rlutz/voctoknopf/panel/CheatSheet.md

GCode cheat sheet
-----------------

Go to G54 zero:
```
G28.3 X0 Y0 Z0
```

Home:
```
G28.2 X0 Y0 Z0
```

Set G54 zero:
```
G10 L2 P1 X... Y... Z...
```

Absolute Zero Pre-Set (set current coordinates):
```
G92 X... Y... Z...
```
