rlutz/voctoknopf/panel/matrix3-preview.pdf

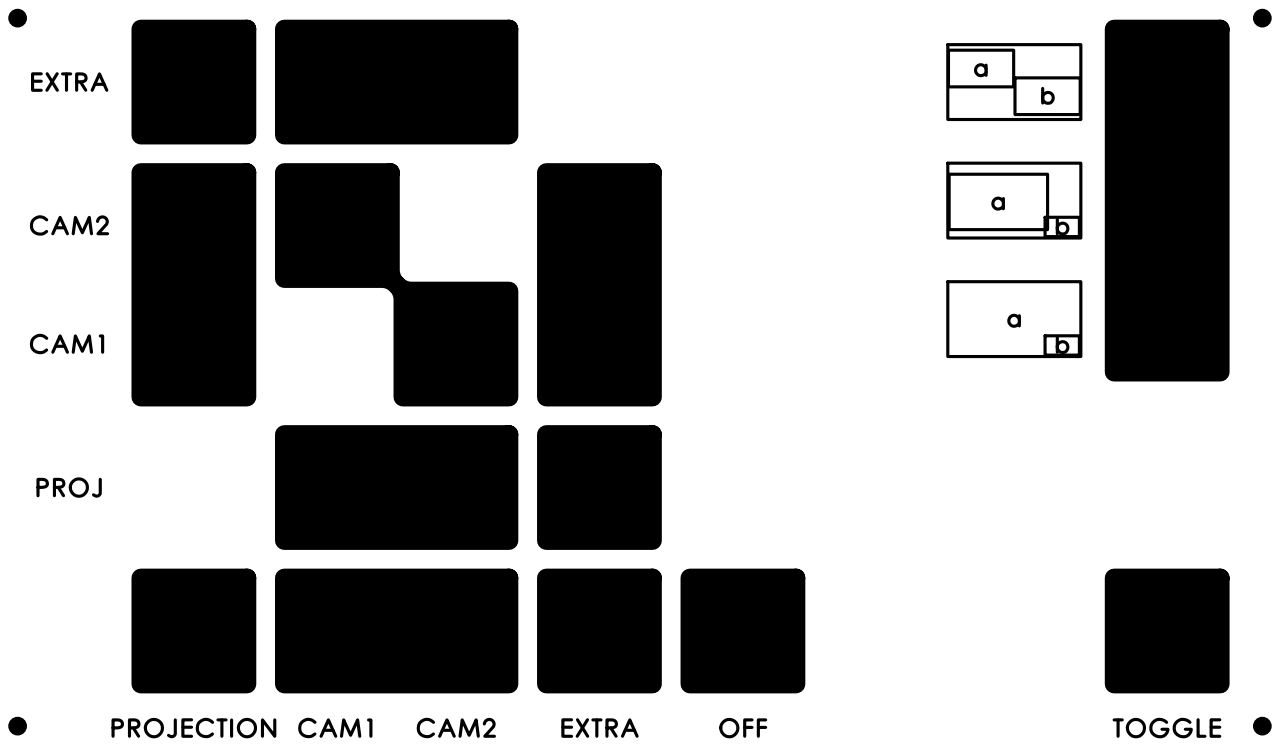
[picture p3: page 1]
