rlutz/voctoknopf/panel/p2-preview.png

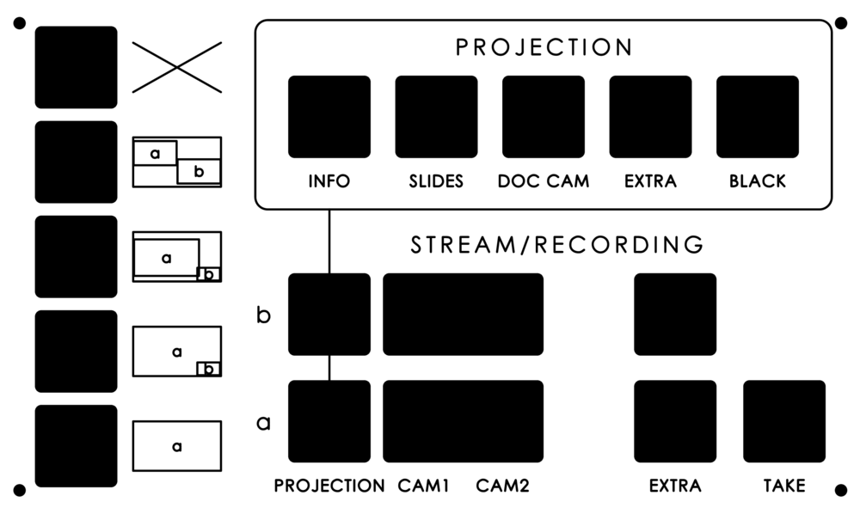
panel/p2-preview.png
