rlutz/voctoknopf/prototype-rear.jpg

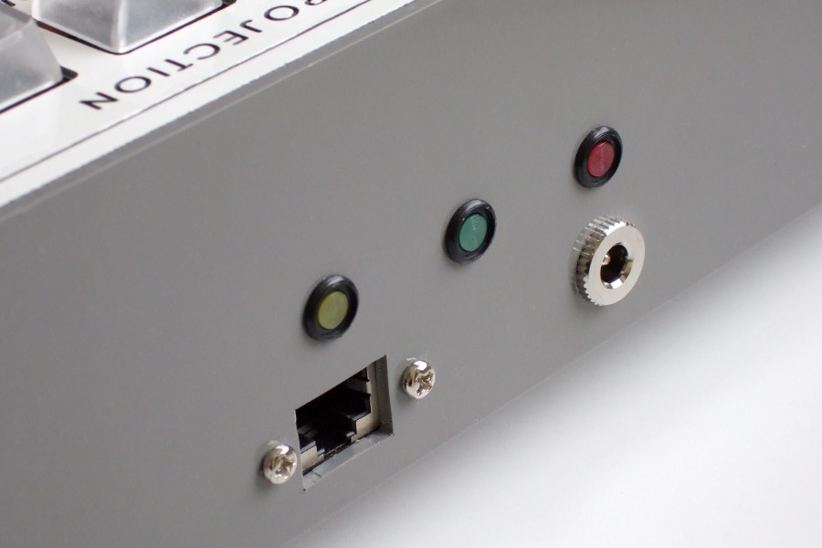
prototype-rear.jpg
