rlutz/voctoknopf/board/voctoknopf.pdf

## RT5350F-OLinuXino

# Power GND EXT1-2 GND EXT2-2

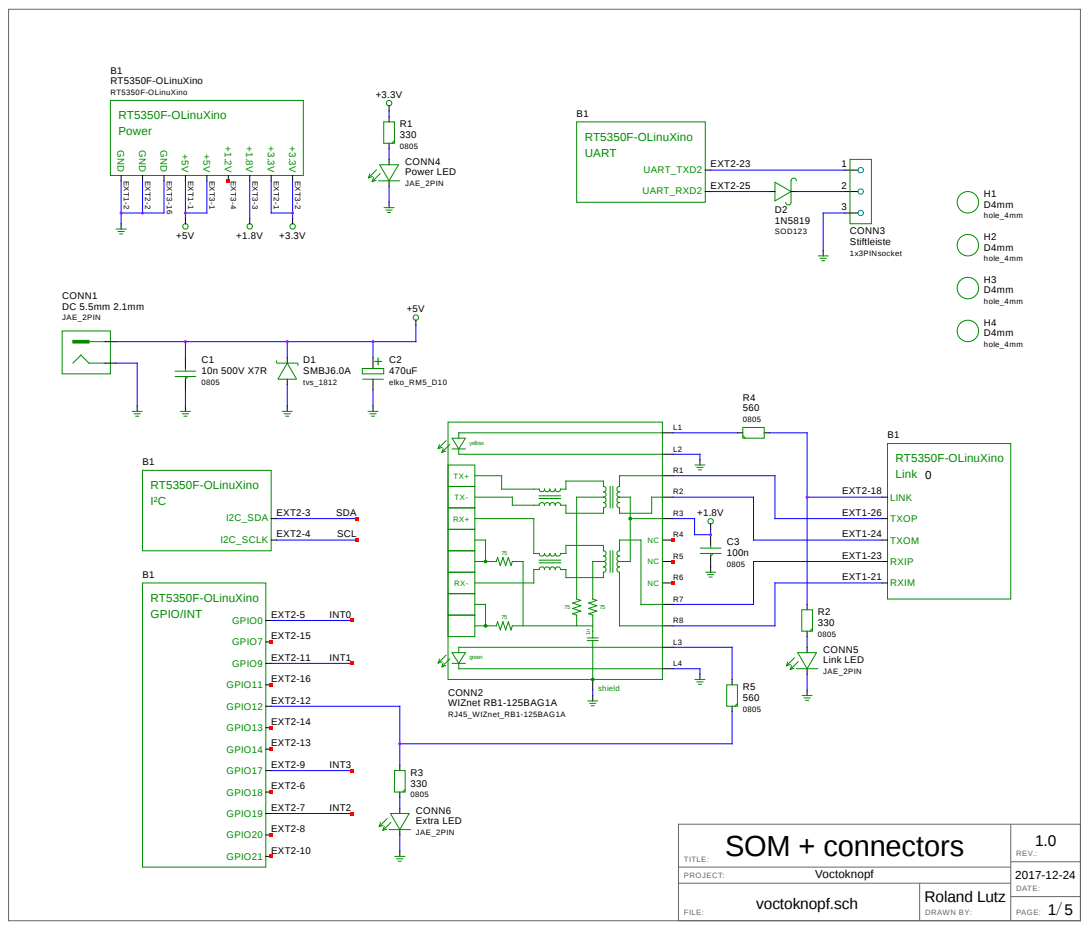
[picture p6: page 1]

## Red/green LED

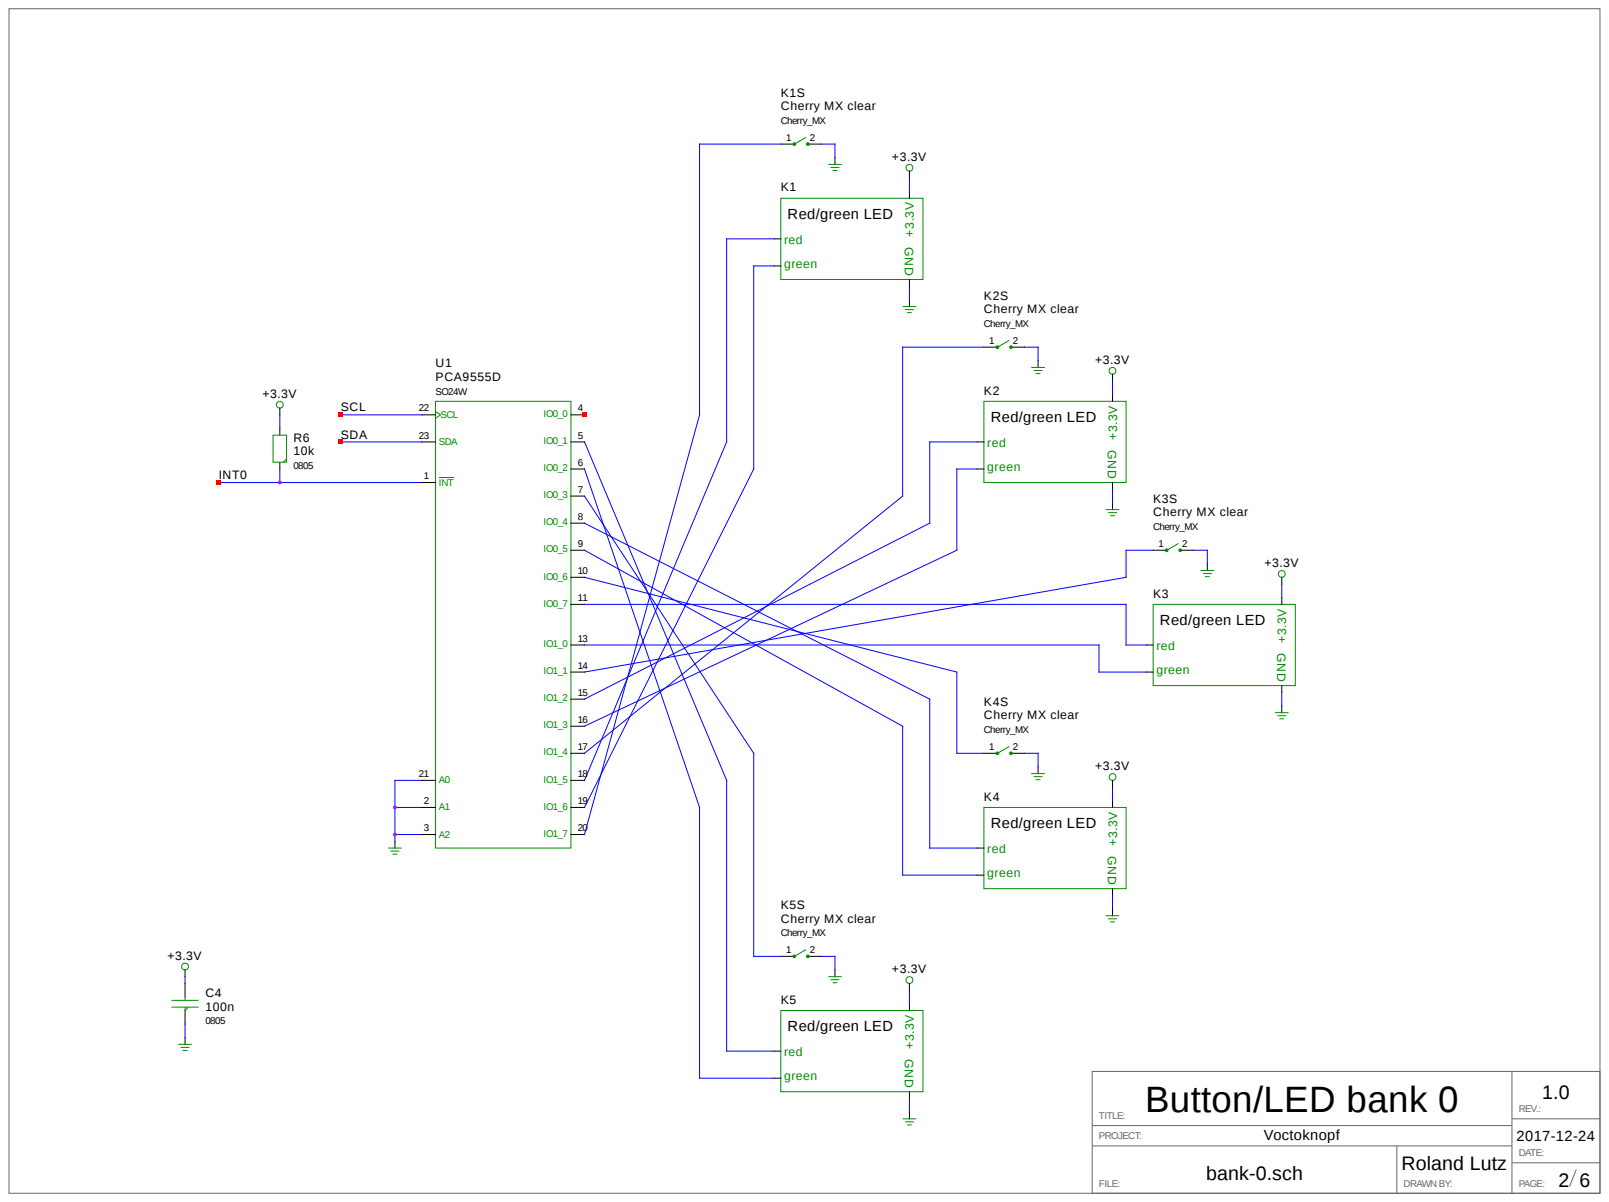
[picture p7: page 2]
TITLE:; REV.:; PROJECT:; bank-0.sch; Voctoknopf; SCL; SDA; INT0; K1S Cherry MX clear Cherry_MX; red; GND; green; 23 SDA; 22 SCL; 1 INT; U1 PCA9555D SO24W; K2S Cherry MX clear Cherry_MX; K3S Cherry MX clear Cherry_MX; K4S Cherry MX clear Cherry_MX; K5S Cherry MX clear Cherry_MX

Red/green LED

Button/LED bank 0

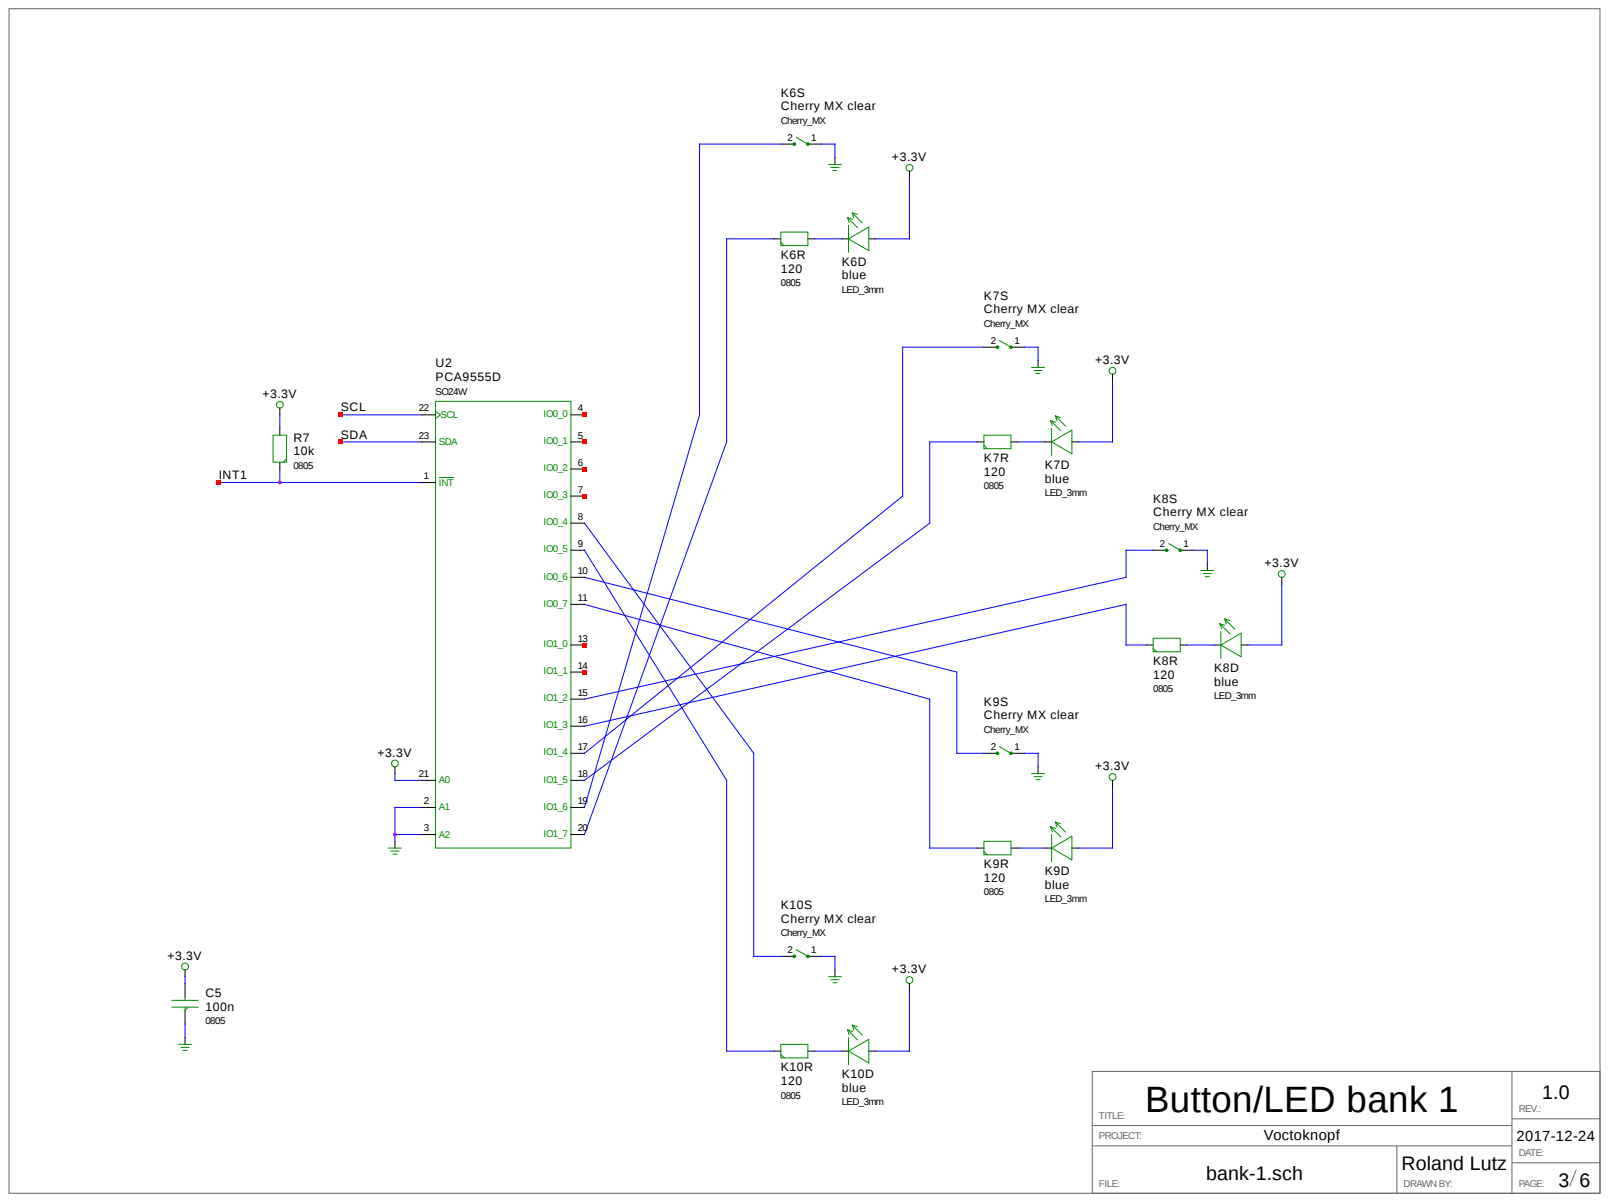
[picture p8: page 3]
TITLE:; REV.:; PROJECT:; bank-1.sch; Voctoknopf; SCL; SDA; INT1; K6S Cherry MX clear Cherry_MX; 23 SDA; 22 SCL; 1 INT; U2 PCA9555D SO24W; K7S Cherry MX clear Cherry_MX; K8S Cherry MX clear Cherry_MX; K9S Cherry MX clear Cherry_MX; K10S Cherry MX clear Cherry_MX; K6D blue LED_3mm; K7D blue LED_3mm; K8D blue LED_3mm; K9D blue LED_3mm; K10D blue LED_3mm

Button/LED bank 1

## Red/green LED

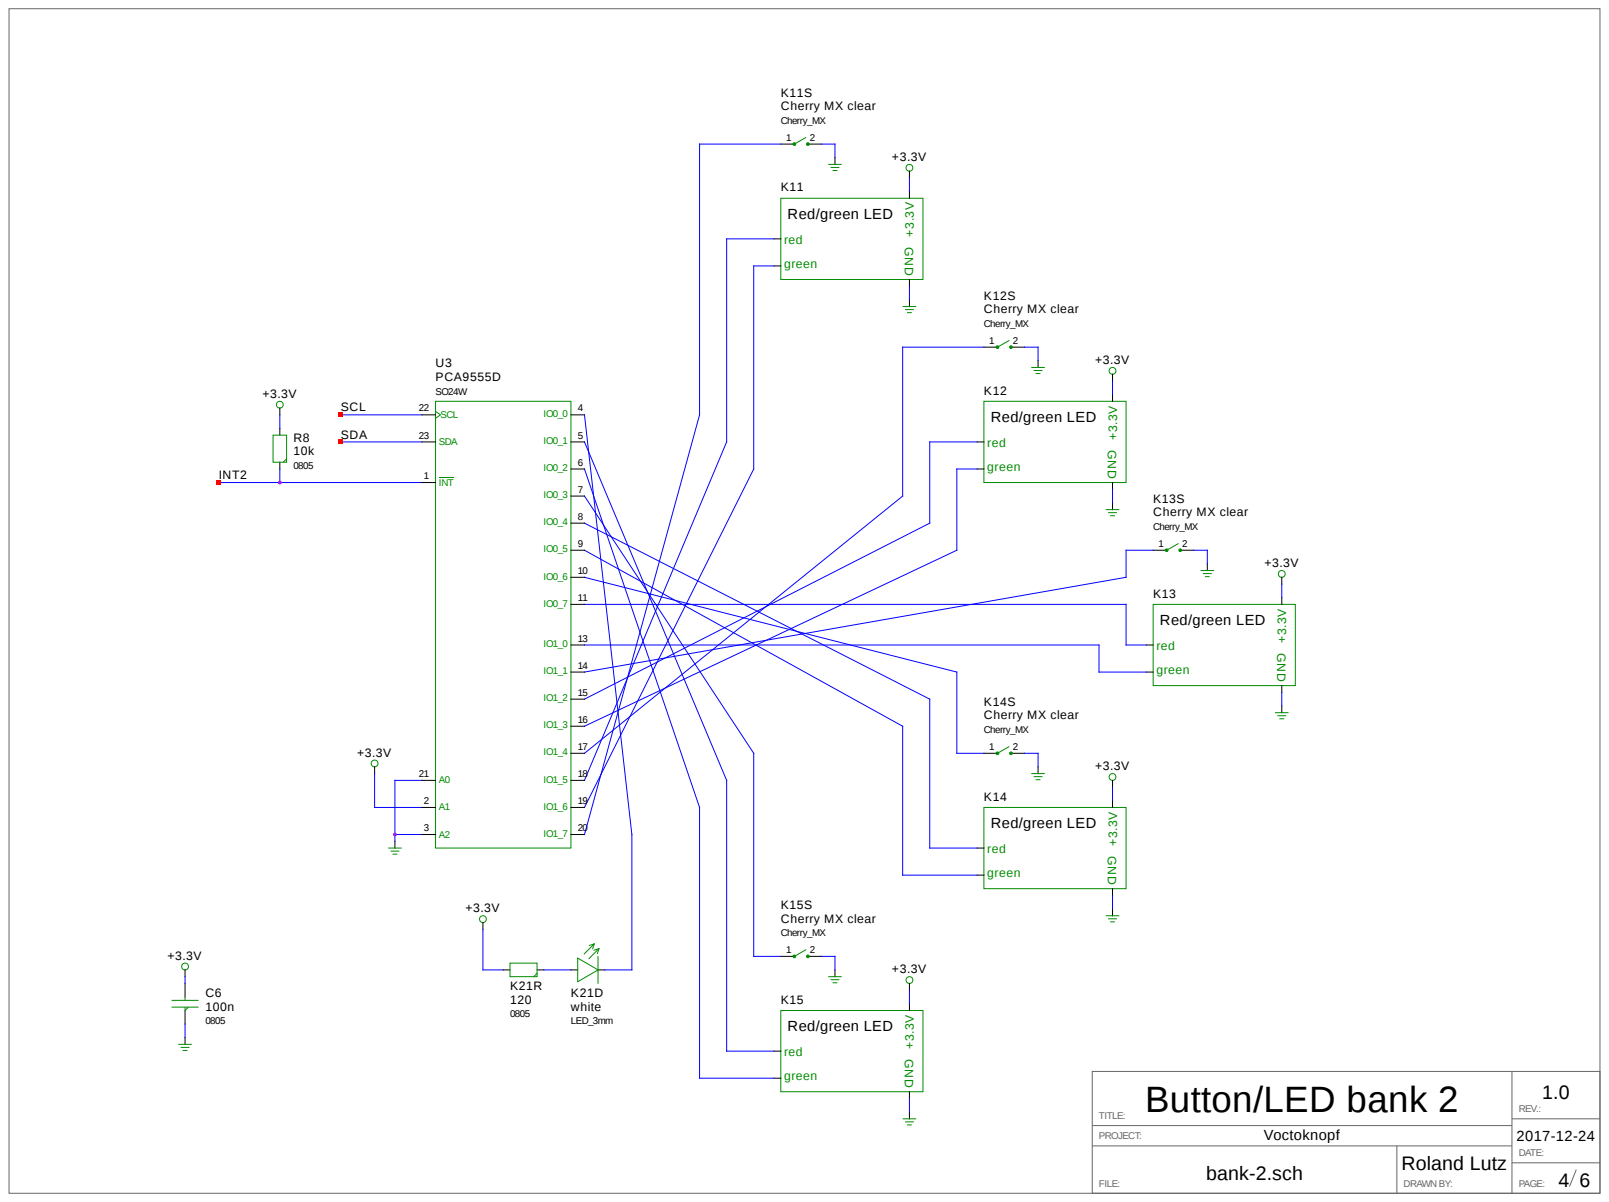
[picture p9: page 4]
TITLE:; REV.:; PROJECT:; bank-2.sch; Voctoknopf; SCL; SDA; INT2; K11S Cherry MX clear Cherry_MX; red; GND; green; 23 SDA; 22 SCL; 1 INT; U3 PCA9555D SO24W; K12S Cherry MX clear Cherry_MX; K13S Cherry MX clear Cherry_MX; K14S Cherry MX clear Cherry_MX; K15S Cherry MX clear Cherry_MX; K21D white LED_3mm

Red/green LED

Button/LED bank 2

## Red/green LED

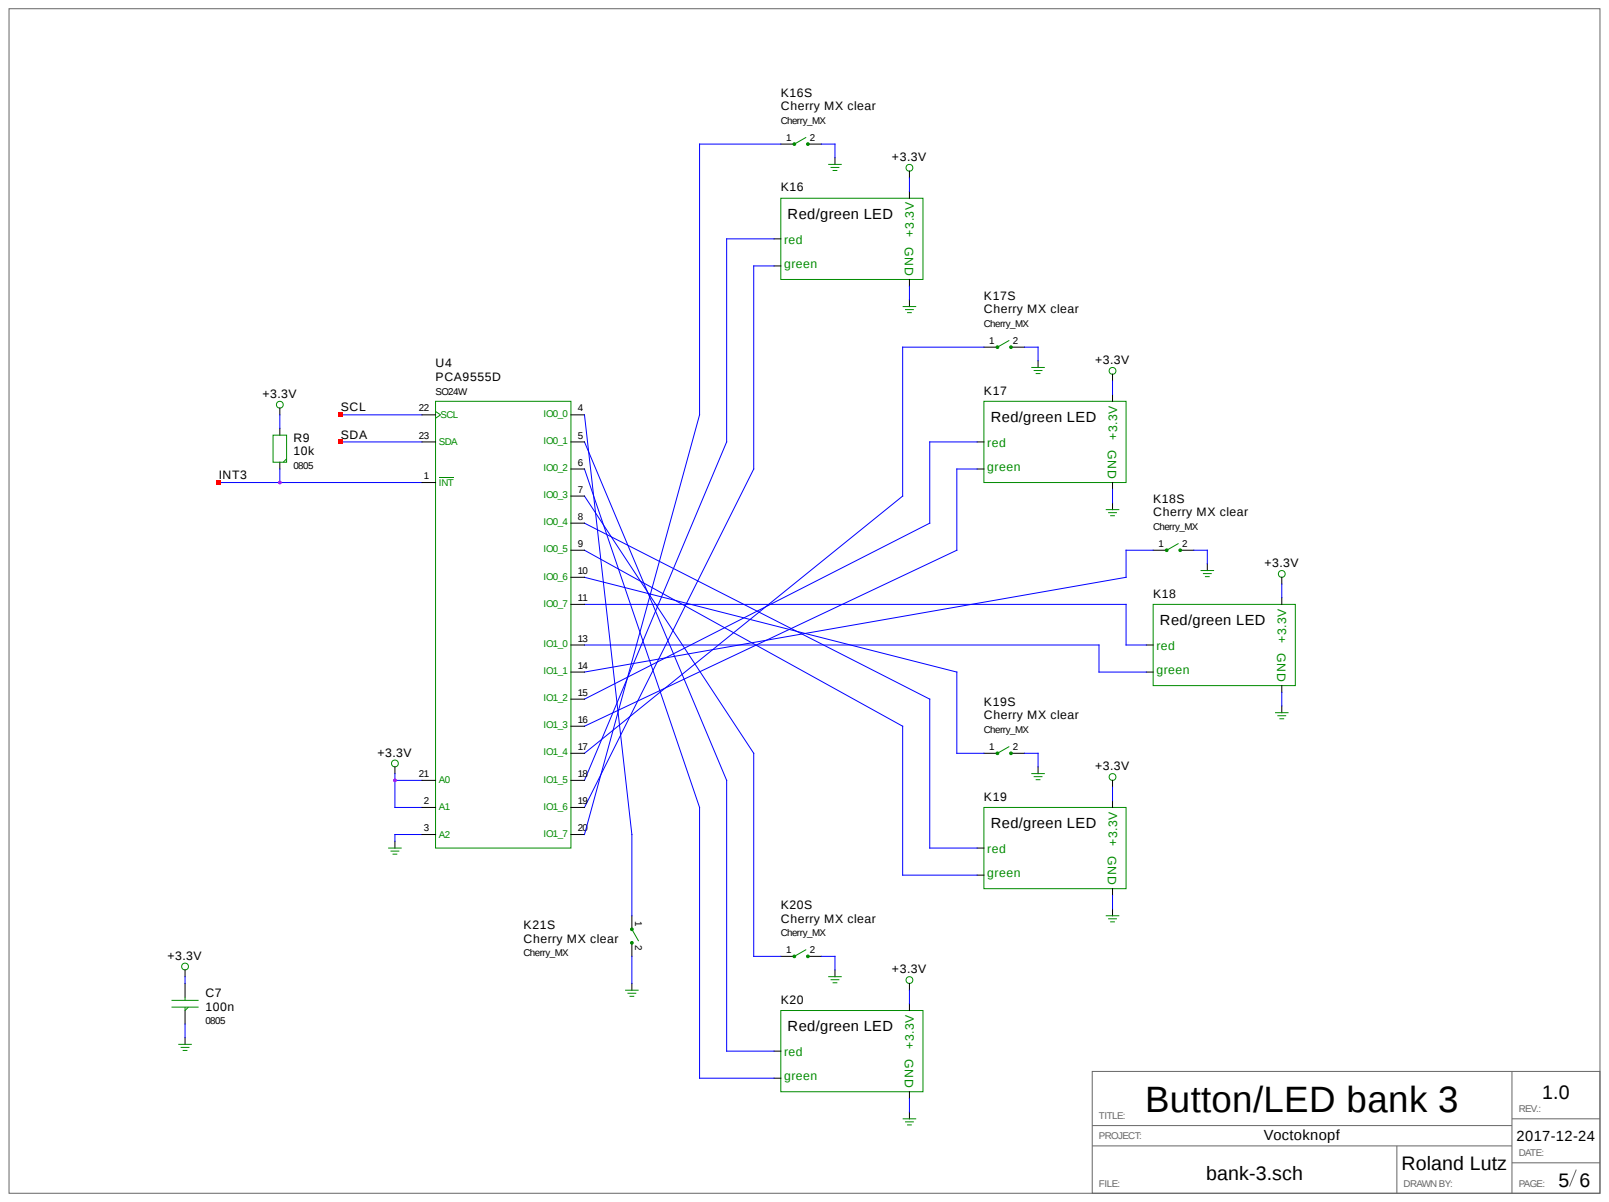
[picture p10: page 5]
TITLE:; REV.:; PROJECT:; bank-3.sch; Voctoknopf; SCL; SDA; INT3; K16S Cherry MX clear Cherry_MX; red; GND; green; 23 SDA; 22 SCL; 1 INT; U4 PCA9555D SO24W; K17S Cherry MX clear Cherry_MX; K18S Cherry MX clear Cherry_MX; K19S Cherry MX clear Cherry_MX; K20S Cherry MX clear Cherry_MX; Cherry_MX

Red/green LED

Cherry MX clear

Button/LED bank 3

4

4

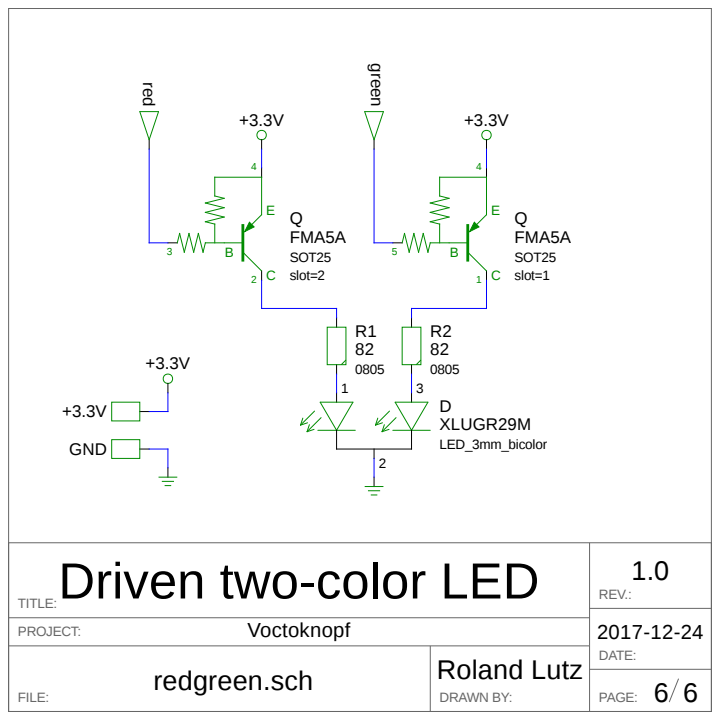
[picture p11: page 6]
TITLE:; REV.:; DATE:; PROJECT:; redgreen.sch; Roland Lutz; Voctoknopf; D XLUGR29M LED_3mm_bicolor; SOT25; FMA5A; slot=2; slot=1; red; green; GND

Driven two-color LED
