rlutz/voctoknopf/panel/p2-preview.pdf

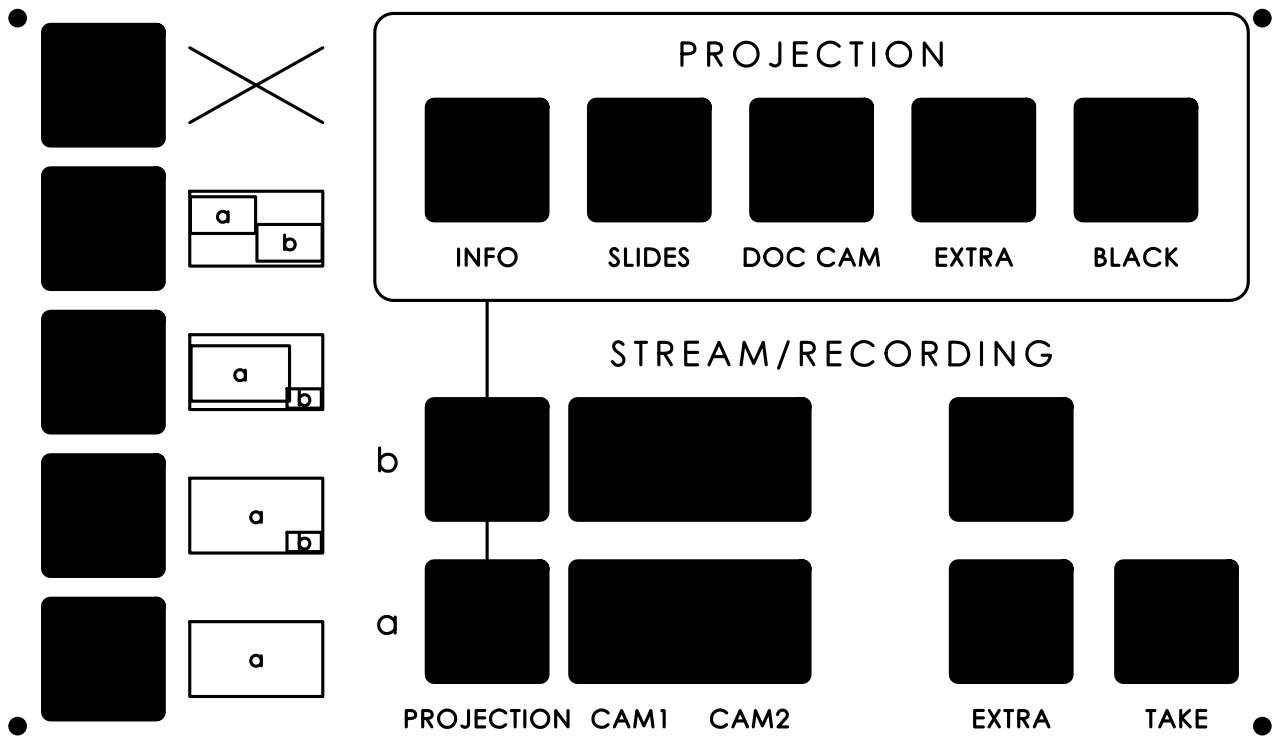
[picture p12: page 1]
