rlutz/voctoknopf/panel/p3-preview.pdf

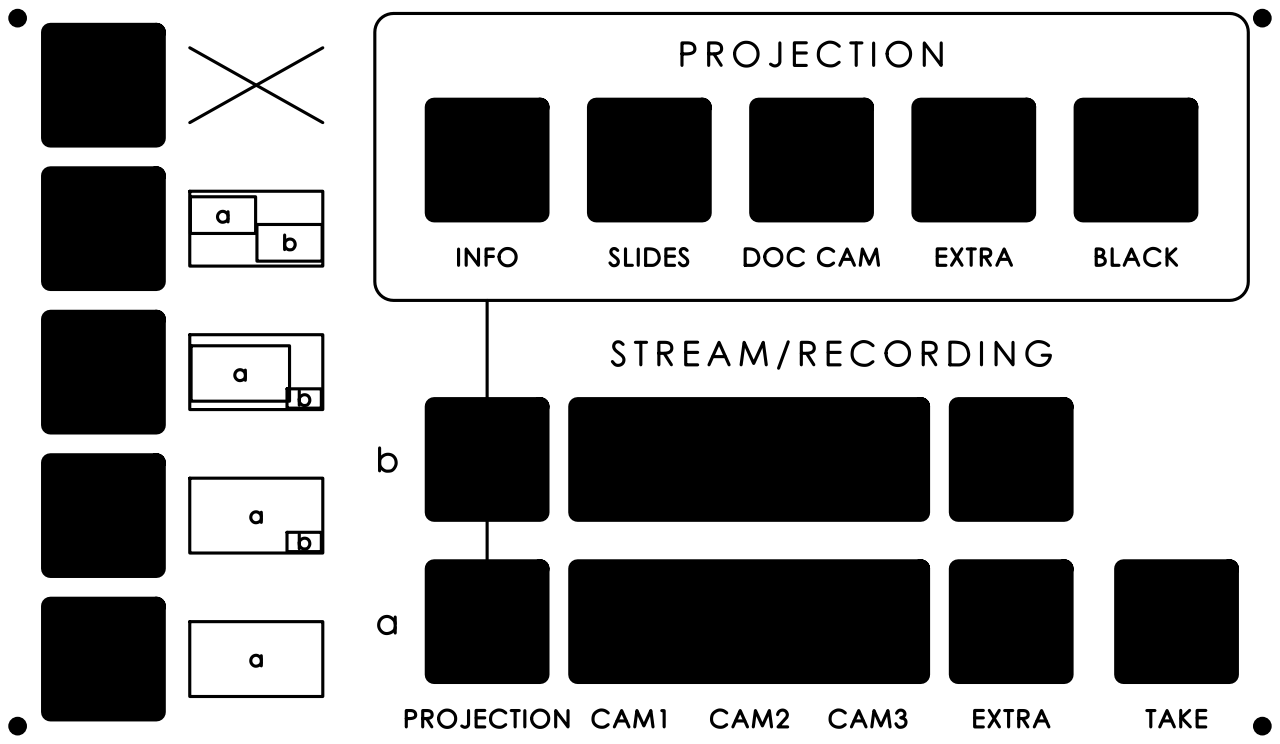
[picture p13: page 1]
