rlutz/voctoknopf/(list of files, drawings)

Other design files:
board/voctoknopf.pcb
