rlutz/voctoknopf/(commit log)

2018-05-16 src: Deactivate unused source buttons
2018-05-16 src: Switch to appropriate mode when extra source is selected
2018-10-26 src: Fix extra LED initialization
    [main.c]
2018-10-28 src: Fix missing LED update
2018-10-28 src: Move device-specific definitions into separate file
2018-10-28 src: Make button handling more generic
2018-10-28 src: Remove hard-coded button-IRQ association
2018-10-28 src: Allow building multiple device/task combinations
2018-11-01 src: Fix signed loop index
    [main.c]
2018-11-01 src: Allow using LED subsystem for regular LEDs
2018-11-01 src: Add device tree overlay for tally Pi
